ketzelG-22310245/All-Magnetic-Terrain-Quadruped-AMTQ-/ros2_ws/src/quadruped_description/quadruped/assets/support_right_3__3_5__3_5__diameter_hole1.stl

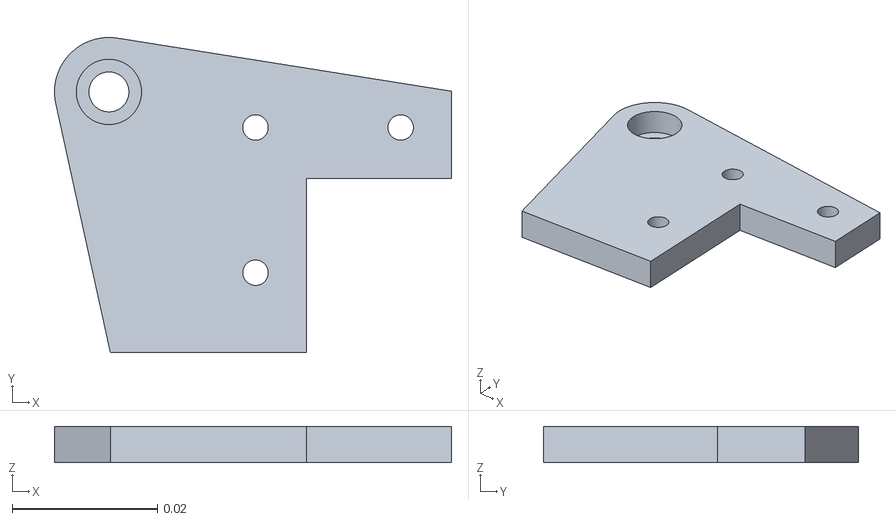
[picture p40: CAD file, 2026-09-14]
ros2_ws/src/quadruped_description/quadruped/assets/support_right_3__3_5__3_5__diameter_hole1.stl
0.0547 x 0.0434 x 0.005
