ketzelG-22310245/All-Magnetic-Terrain-Quadruped-AMTQ-/ros2_ws/src/quadruped_description/quadruped/assets/servo_motor_35kg__body9.stl

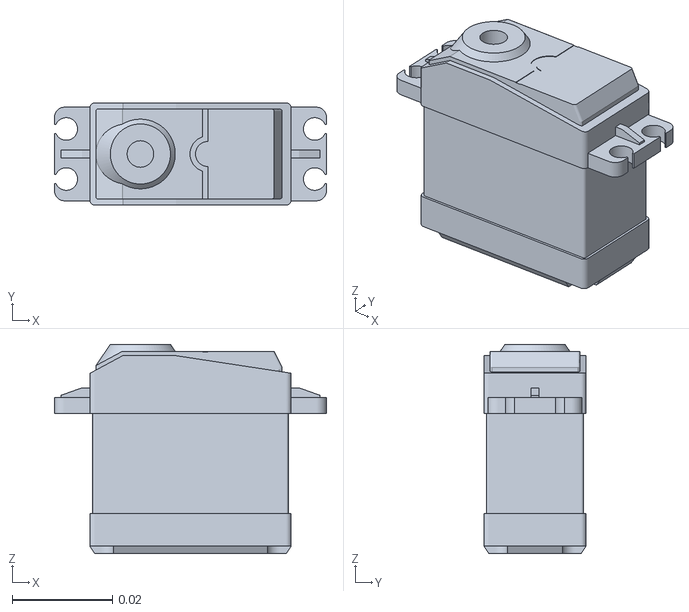
[picture p41: CAD file, 2026-09-14]
ros2_ws/src/quadruped_description/quadruped/assets/servo_motor_35kg__body9.stl
0.0543 x 0.0204 x 0.0418
