ketzelG-22310245/All-Magnetic-Terrain-Quadruped-AMTQ-/ros2_ws/src/quadruped_description/quadruped/assets/case__cut_extrude7.stl

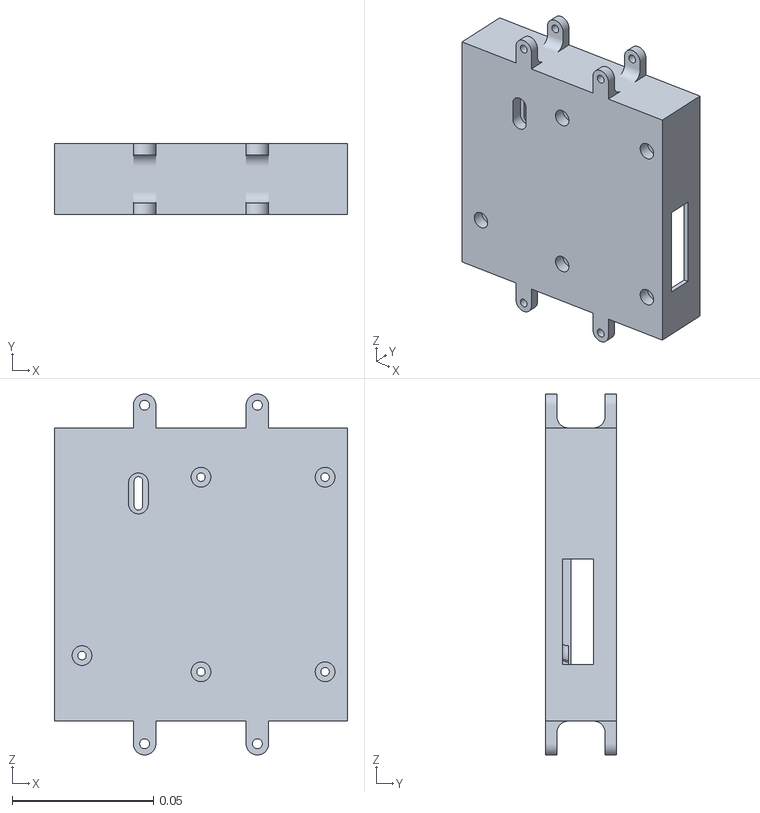
[picture p42: CAD file, 2026-09-14]
ros2_ws/src/quadruped_description/quadruped/assets/case__cut_extrude7.stl
0.104 x 0.025 x 0.128
