ketzelG-22310245/All-Magnetic-Terrain-Quadruped-AMTQ-/ros2_ws/src/quadruped_description/quadruped/assets/pata_con_iman__cut_extrude6.stl

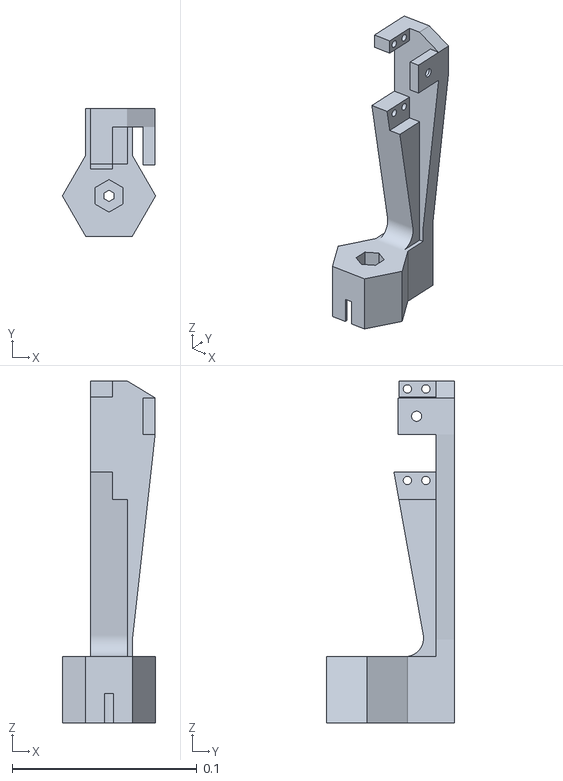
[picture p43: CAD file, 2026-09-14]
ros2_ws/src/quadruped_description/quadruped/assets/pata_con_iman__cut_extrude6.stl
0.0506 x 0.0691 x 0.185
