ketzelG-22310245/All-Magnetic-Terrain-Quadruped-AMTQ-/ros2_ws/src/quadruped_description/quadruped/assets/arm_2_3__cut_extrude4.stl

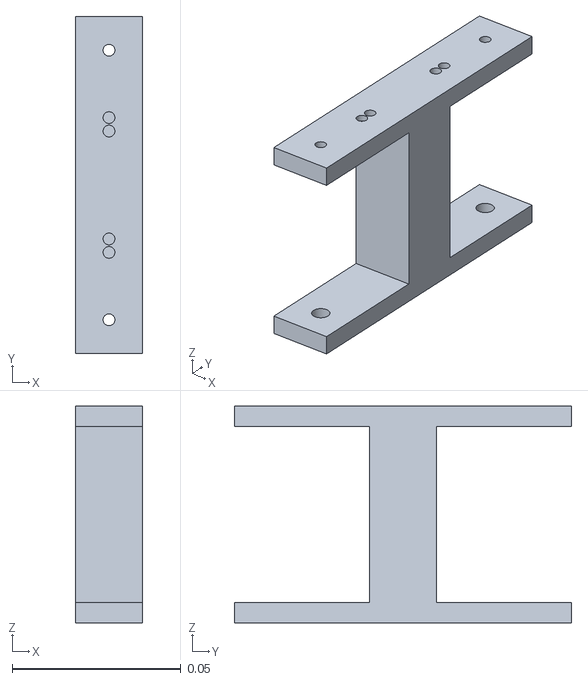
[picture p44: CAD file, 2026-09-14]
ros2_ws/src/quadruped_description/quadruped/assets/arm_2_3__cut_extrude4.stl
0.02 x 0.1 x 0.0643
