ketzelG-22310245/All-Magnetic-Terrain-Quadruped-AMTQ-/ros2_ws/src/quadruped_description/quadruped/assets/aluminium_25t_servo_horn_3__body1.stl

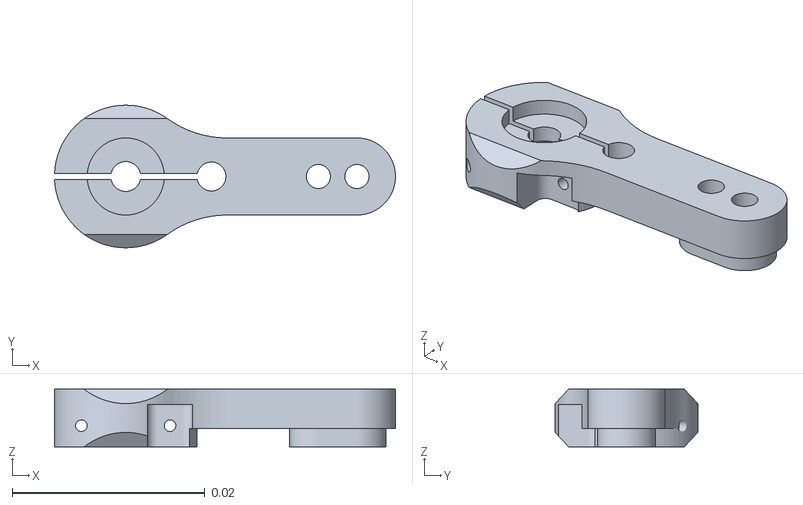
[picture p45: CAD file, 2026-09-14]
ros2_ws/src/quadruped_description/quadruped/assets/aluminium_25t_servo_horn_3__body1.stl
0.0354 x 0.0148 x 0.006
