ketzelG-22310245/All-Magnetic-Terrain-Quadruped-AMTQ-/ros2_ws/src/quadruped_description/quadruped/assets/servo_holder_3__boss_extrude1.stl

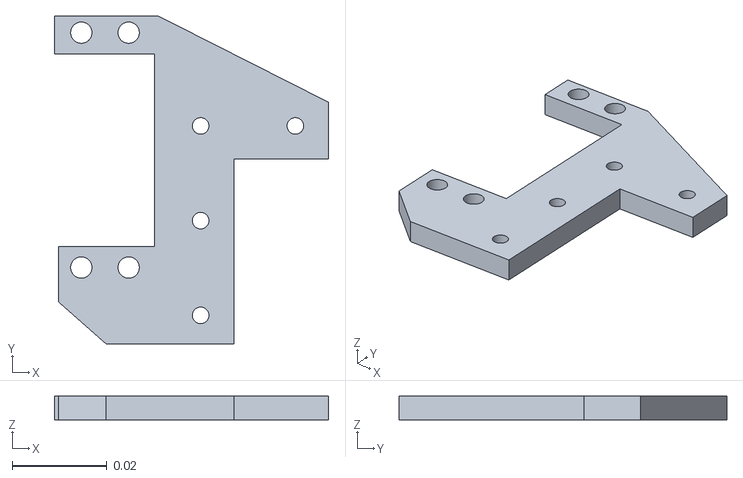
[picture p46: CAD file, 2026-09-14]
ros2_ws/src/quadruped_description/quadruped/assets/servo_holder_3__boss_extrude1.stl
0.0579 x 0.0692 x 0.005
