ketzelG-22310245/All-Magnetic-Terrain-Quadruped-AMTQ-/ros2_ws/src/quadruped_description/quadruped/assets/base_link.stl

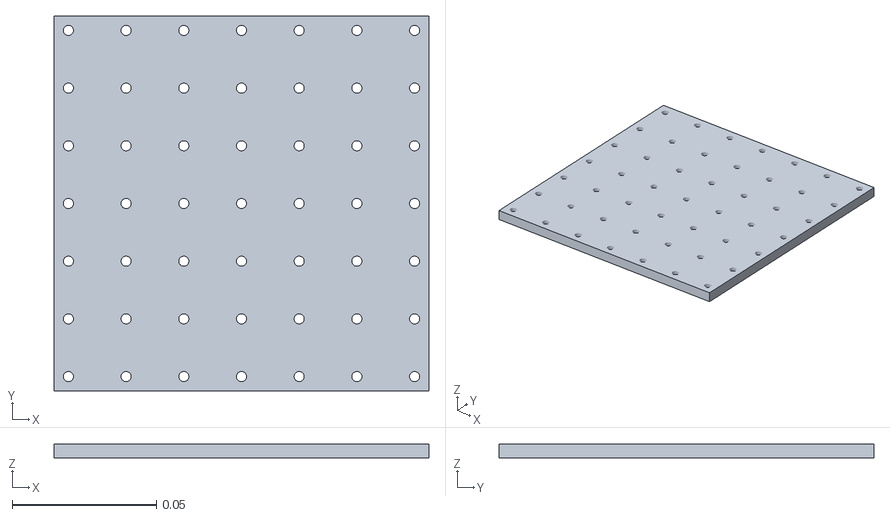
[picture p47: CAD file, 2026-09-14]
ros2_ws/src/quadruped_description/quadruped/assets/base_link.stl
0.13 x 0.13 x 0.005
