ketzelG-22310245/All-Magnetic-Terrain-Quadruped-AMTQ-/ros2_ws/src/quadruped_description/quadruped/assets/arm_1_3__cut_extrude2.stl

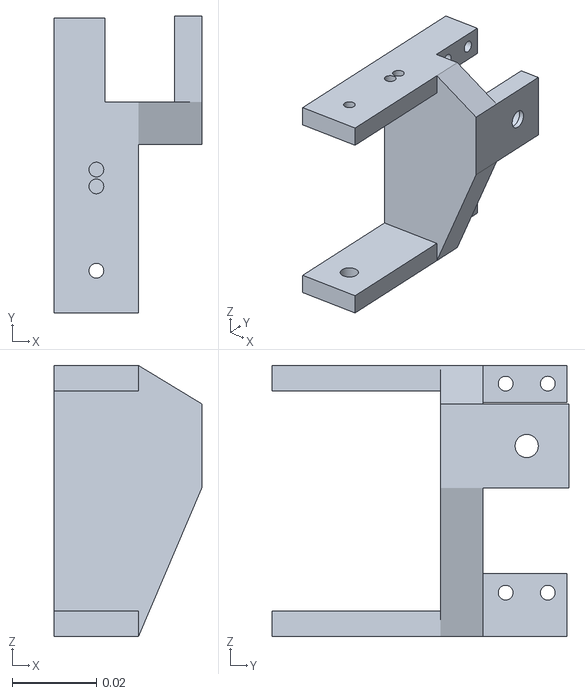
[picture p48: CAD file, 2026-09-14]
ros2_ws/src/quadruped_description/quadruped/assets/arm_1_3__cut_extrude2.stl
0.035 x 0.0704 x 0.0643
