ketzelG-22310245/All-Magnetic-Terrain-Quadruped-AMTQ-/(list of files, cad)

Other CAD files:
ros2_ws/src/quadruped_description/quadruped/assets/support_left_3__3_5__3_5__diameter_hole1.stl
