ketzelG-22310245/All-Magnetic-Terrain-Quadruped-AMTQ-/ros2_ws/femur_step_response.csv

time_s | torque_cmd_Nm | position_rad | velocity_rad_s | effort_measured_Nm
0.0007154941558837891 | 0.0 | -1.0874509452640863e-13 | 0.0 | 0.13982759152765933
0.0017611980438232422 | 0.0 | -1.0874510840419644e-13 | -1.3877787807814457e-17 | 0.1398275915276541
0.0023915767669677734 | 0.0 | -1.0874509452640863e-13 | 0.0 | 0.1398275915276491
0.0029904842376708984 | 0.0 | -1.0874513615977206e-13 | 1.3877787807814457e-17 | 0.13982759152764399
0.0033845901489257812 | 0.0 | -1.0874515003755987e-13 | -2.7755575615628914e-17 | 0.13982759152763888
0.003760814666748047 | 0.0 | -1.0874508064862083e-13 | -1.3877787807814457e-17 | 0.13982759152763366
0.004301548004150391 | 0.0 | -1.0874508064862083e-13 | 1.3877787807814457e-17 | 0.13982759152762872
0.0048558712005615234 | 0.0 | -1.0874509452640864e-13 | -1.3877787807814457e-17 | 0.1398275915276235
0.0053806304931640625 | 0.0 | -1.0874513615977206e-13 | -1.3877787807814457e-17 | 0.13982759152761842
0.0060710906982421875 | 0.0 | -1.0874515003755987e-13 | -1.3877787807814457e-17 | 0.13982759152761334
0.012759685516357422 | 0.0 | -1.0874510840419644e-13 | 1.3877787807814457e-17 | 0.13982759152760824
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
