ketzelG-22310245/All-Magnetic-Terrain-Quadruped-AMTQ-/docs/Planos AMTQ Nuevo Logo.pdf

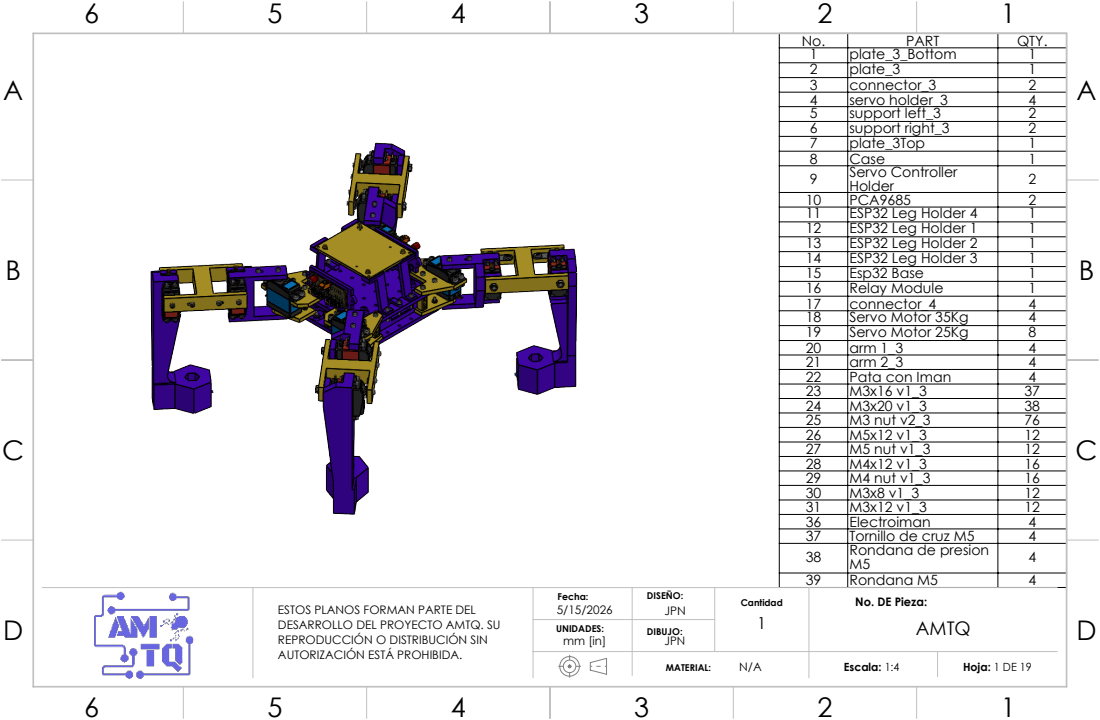
[picture p49: page 1]
PART; QTY. 1; plate_3_Bottom; plate_3; connector_3; servo holder_3; support left_3; support right_3; plate_3Top; Case; Servo Controller; Rondana M5; Cantidad; No. DE Pieza:; MATERIAL:; Escala: 1:4; Hoja: 1 DE 19; 1 DIBUJO:

Holder | 2
10 | PCA9685 | 2
11 | ESP32 Leg Holder 4 | 1
12 | ESP32 Leg Holder 1 | 1
13 | ESP32 Leg Holder 2 | 1
14 | ESP32 Leg Holder 3 | 1
15 | Esp32 Base | 1
16 | Relay Module | 1
17 | connector_4 | 4
18 | Servo Motor 35Kg | 4
19 | Servo Motor 25Kg | 8
20 | arm 1_3 | 4
21 | arm 2_3 | 4
22 | Pata con Iman | 4
23 | M3x16 v1_3 | 37
24 | M3x20 v1_3 | 38
25 | M3 nut v2_3 | 76
26 | M5x12 v1_3 | 12
27 | M5 nut v1_3 | 12
28 | M4x12 v1_3 | 16
29 | M4 nut v1_3 | 16
30 | M3x8 v1_3 | 12
31 | M3x12 v1_3 | 12
36 | Electroiman | 4
37 | Tornillo de cruz M5 | 4
38 | Rondana de presion M5 | 4

ESTOS PLANOS FORMAN PARTE DEL
DESARROLLO DEL PROYECTO AMTQ. SU
REPRODUCCIÓN O DISTRIBUCIÓN SIN
AUTORIZACIÓN ESTÁ PROHIBIDA.

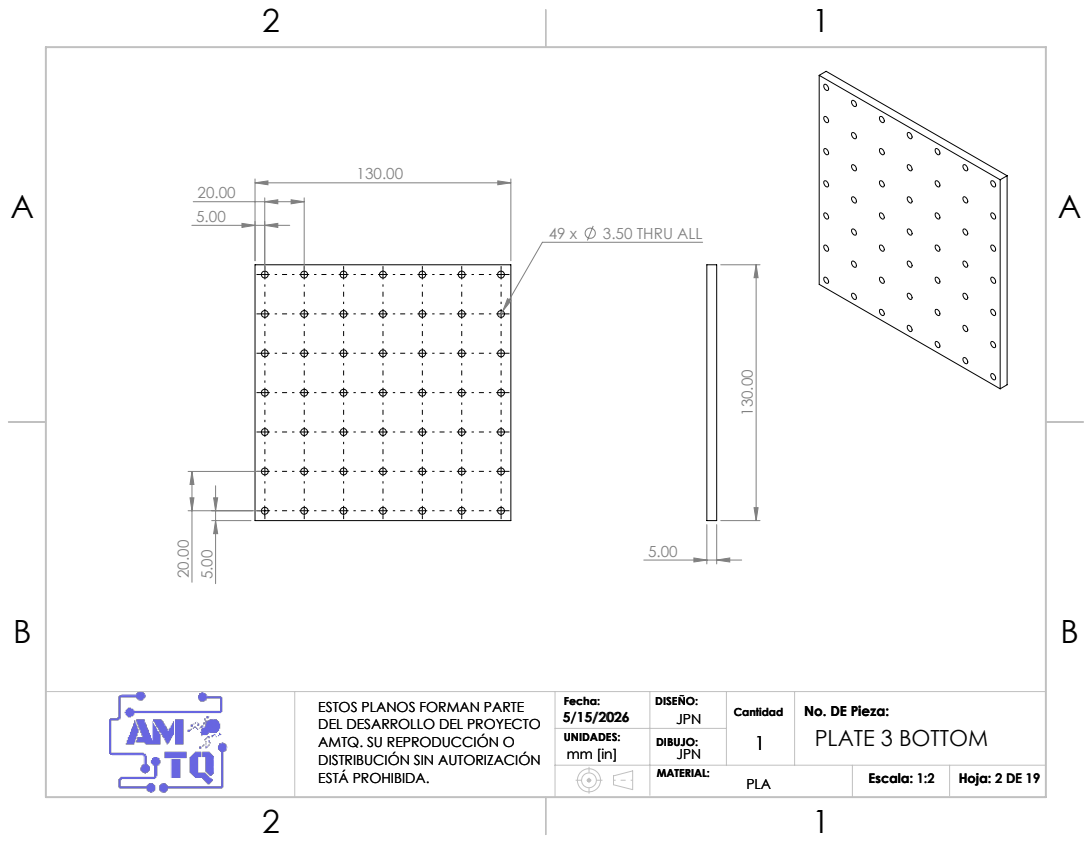
[picture p50: page 2]
3.50 THRU ALL; Cantidad; No. DE Pieza:; MATERIAL:; Escala: 1:2; Hoja: 2 DE 19; PLATE 3 BOTTOM

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

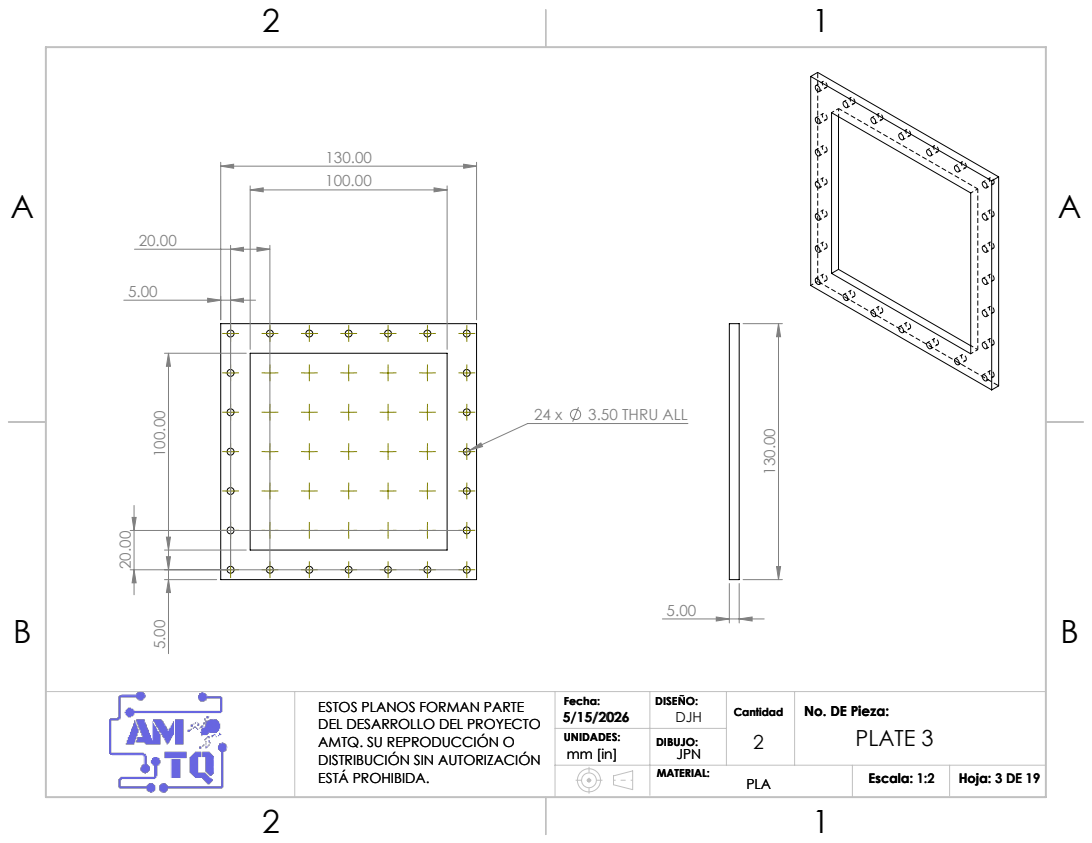
[picture p51: page 3]
3.50 THRU ALL; Cantidad; No. DE Pieza:; MATERIAL:; Escala: 1:2; Hoja: 3 DE 19; PLATE 3

ESTOS PLANOS FORMAN PARTE
DEL DESARROLLO DEL PROYECTO

AMTQ. SU REPRODUCCIÓN O
DISTRIBUCIÓN SIN AUTORIZACIÓN
ESTÁ PROHIBIDA.

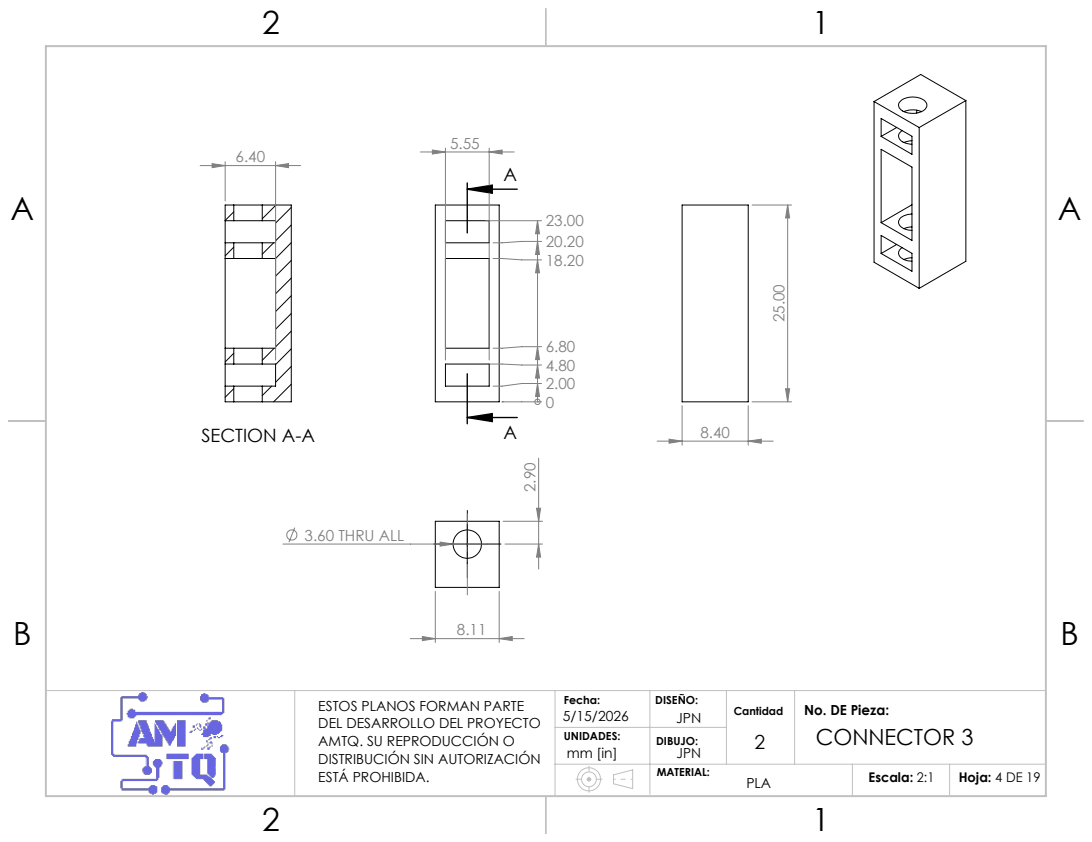
[picture p52: page 4]
3.60 THRU ALL; SECTION A-A; Cantidad; No. DE Pieza:; MATERIAL:; Escala: 2:1; Hoja: 4 DE 19; CONNECTOR 3

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

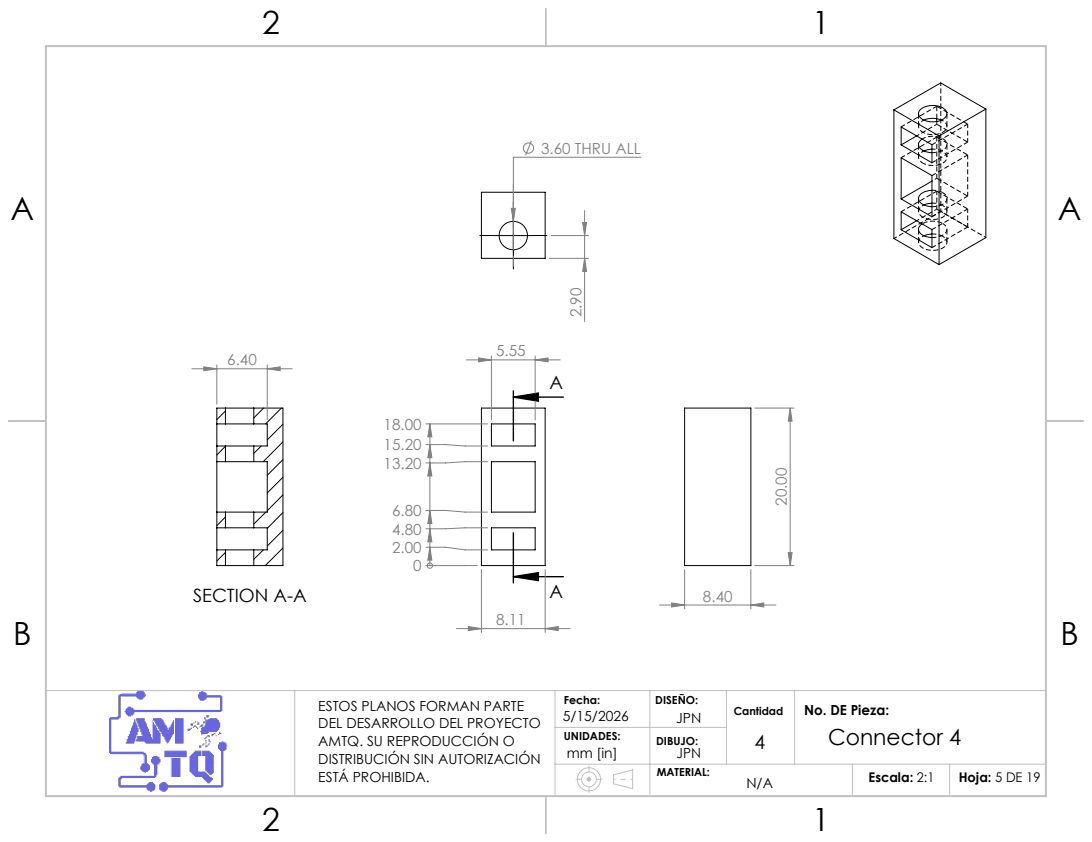
[picture p53: page 5]
3.60 THRU ALL; SECTION A-A; Cantidad; No. DE Pieza:; MATERIAL:; Escala: 2:1; Hoja: 5 DE 19; Connector 4

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

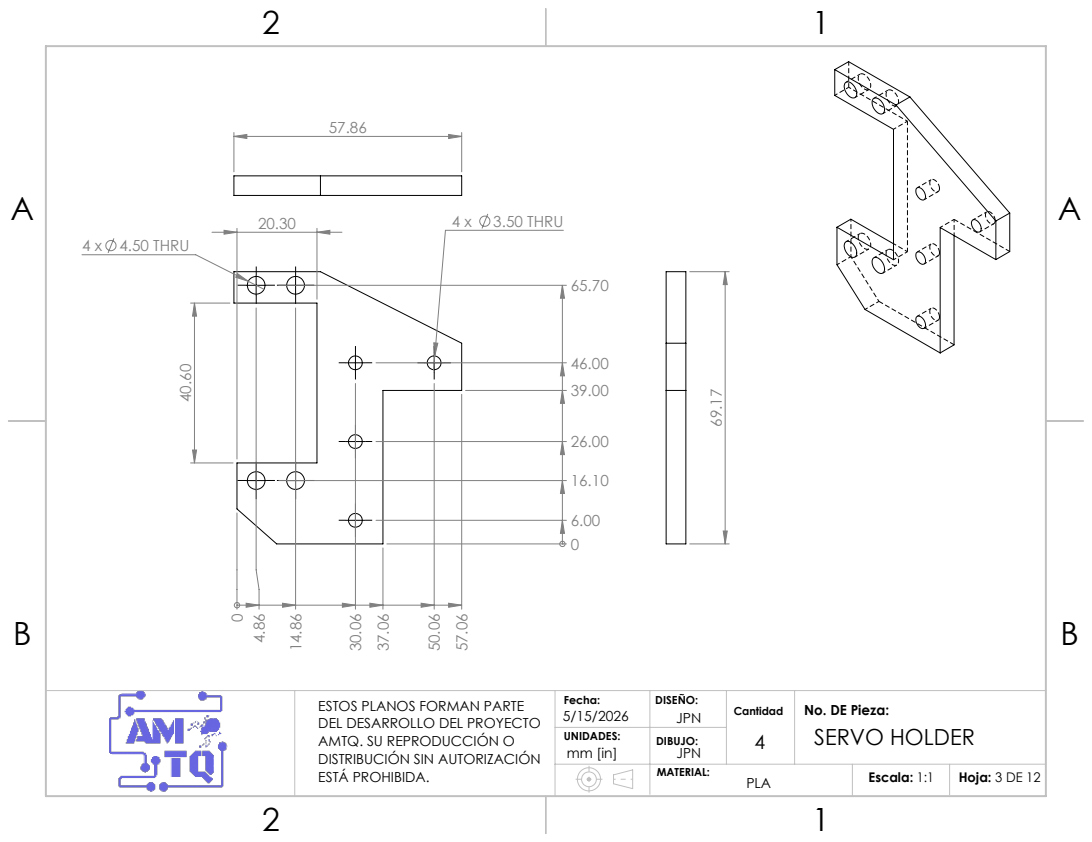
[picture p54: page 6]
4 x 3.50 THRU; 4 x 4.50 THRU; Cantidad; No. DE Pieza:; MATERIAL:; Escala: 1:1; Hoja: 3 DE 12; SERVO HOLDER

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

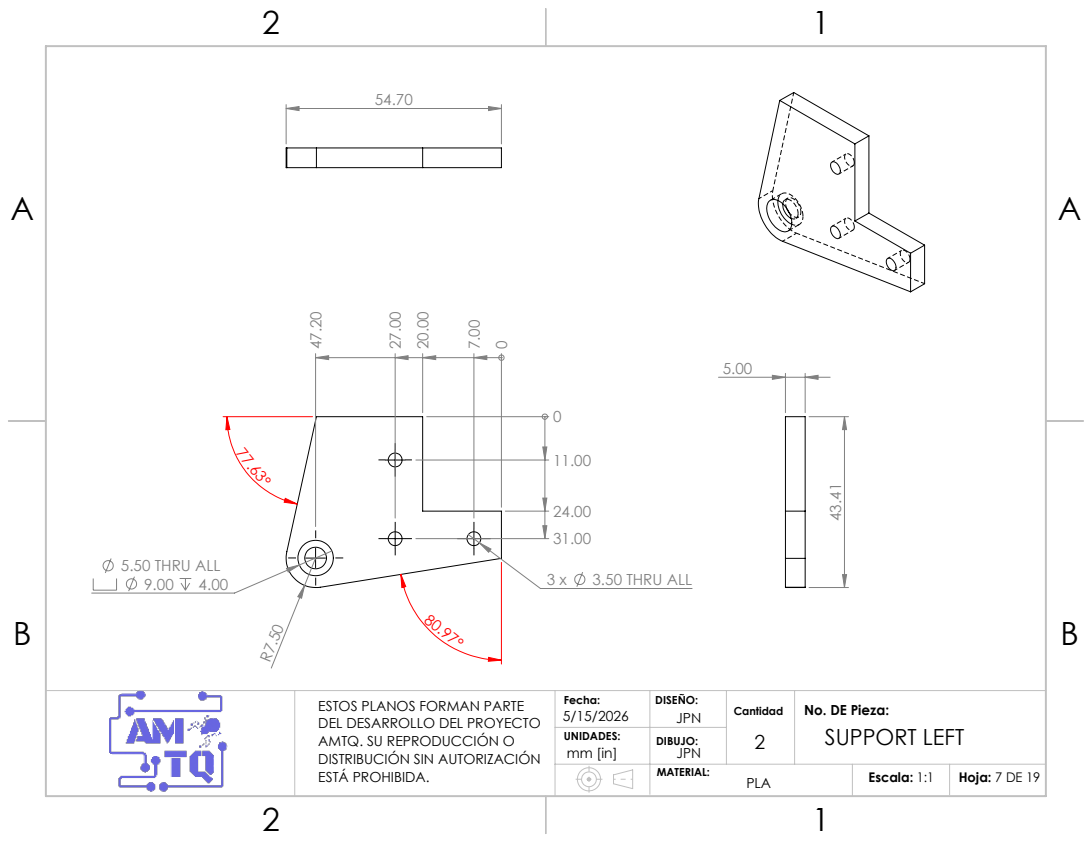
[picture p55: page 7]
5.50 THRU ALL; 3.50 THRU ALL; Cantidad; No. DE Pieza:; MATERIAL:; Escala: 1:1; Hoja: 7 DE 19; SUPPORT LEFT

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

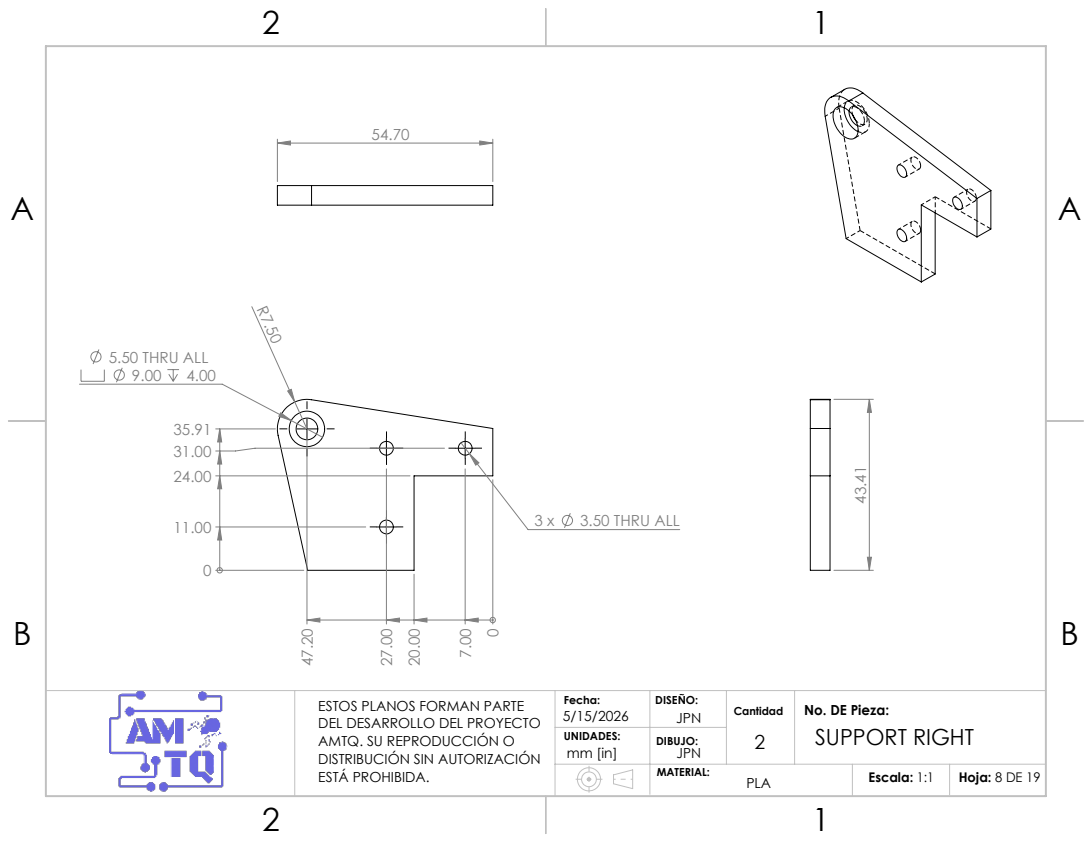
[picture p56: page 8]
5.50 THRU ALL 9.00 4.00; 3.50 THRU ALL; Cantidad; No. DE Pieza:; MATERIAL:; Escala: 1:1; Hoja: 8 DE 19; SUPPORT RIGHT

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

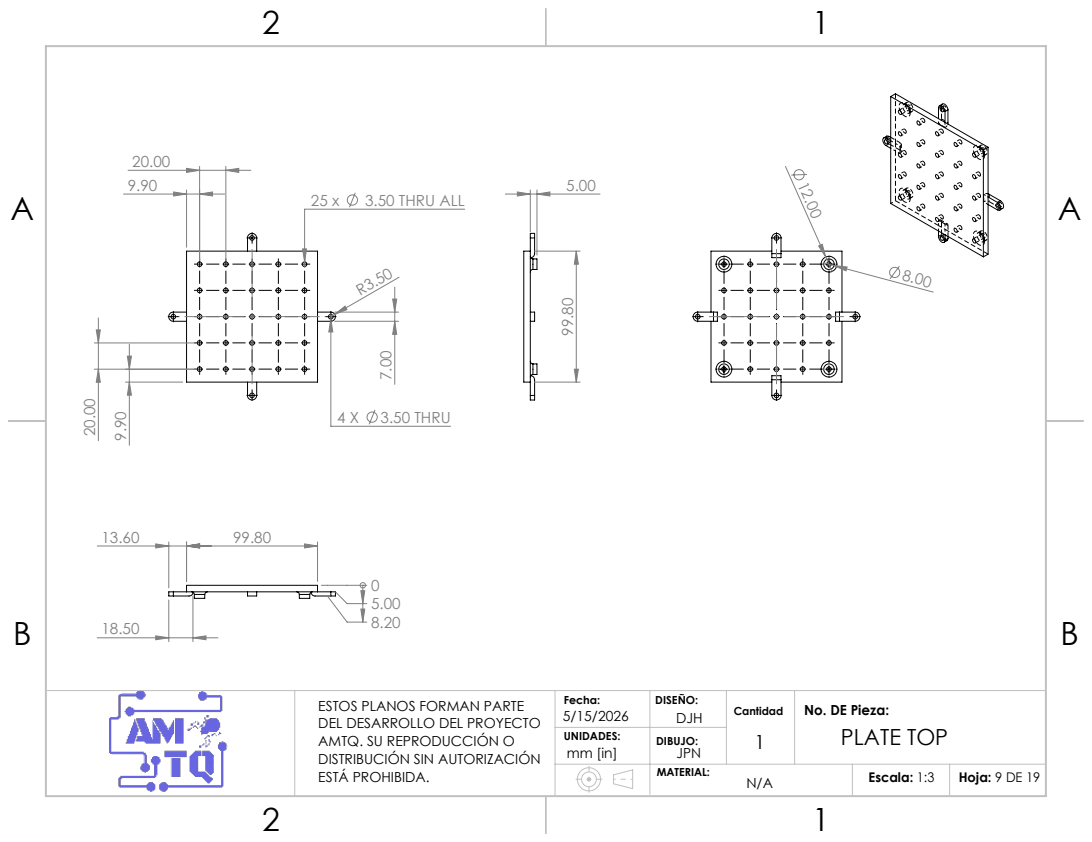
[picture p57: page 9]
3.50 THRU ALL; 4 X 3.50 THRU; Cantidad; No. DE Pieza:; MATERIAL:; Escala: 1:3; Hoja: 9 DE 19; PLATE TOP

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

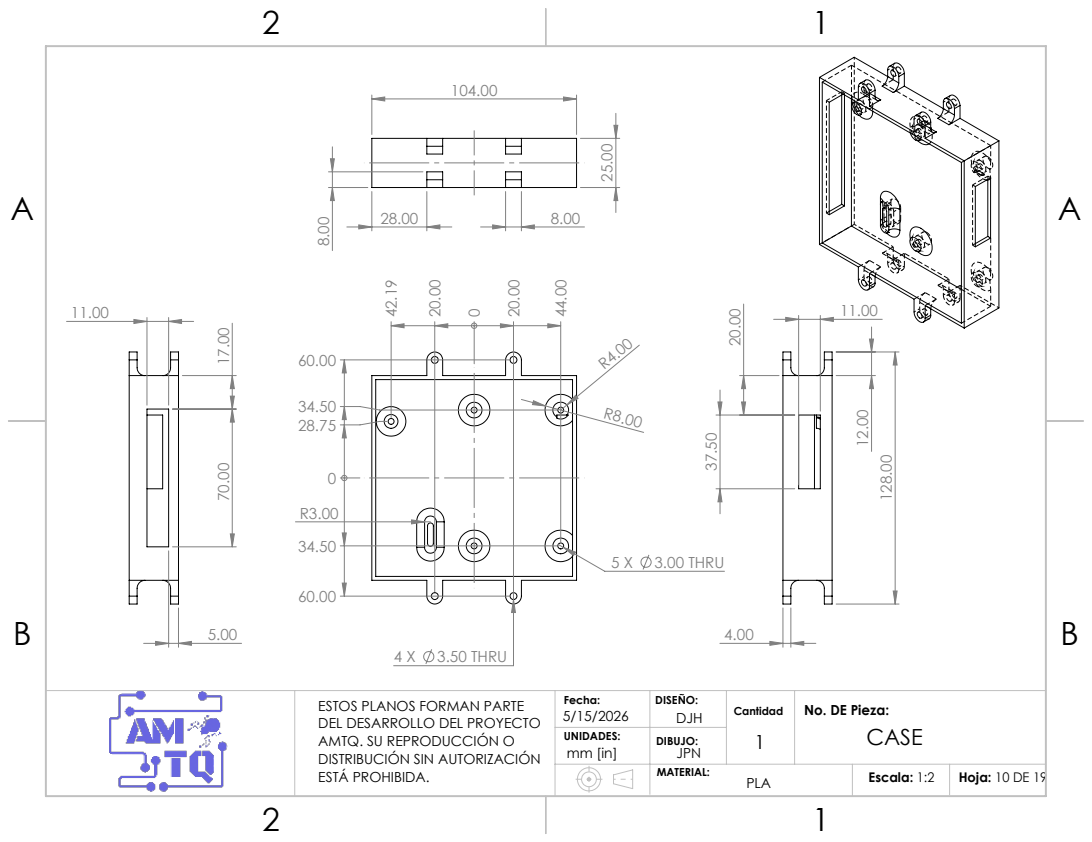
[picture p58: page 10]
5 X 3.00 THRU; 4 X 3.50 THRU; Cantidad; No. DE Pieza:; MATERIAL:; Escala: 1:2; Hoja: 10 DE 19

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

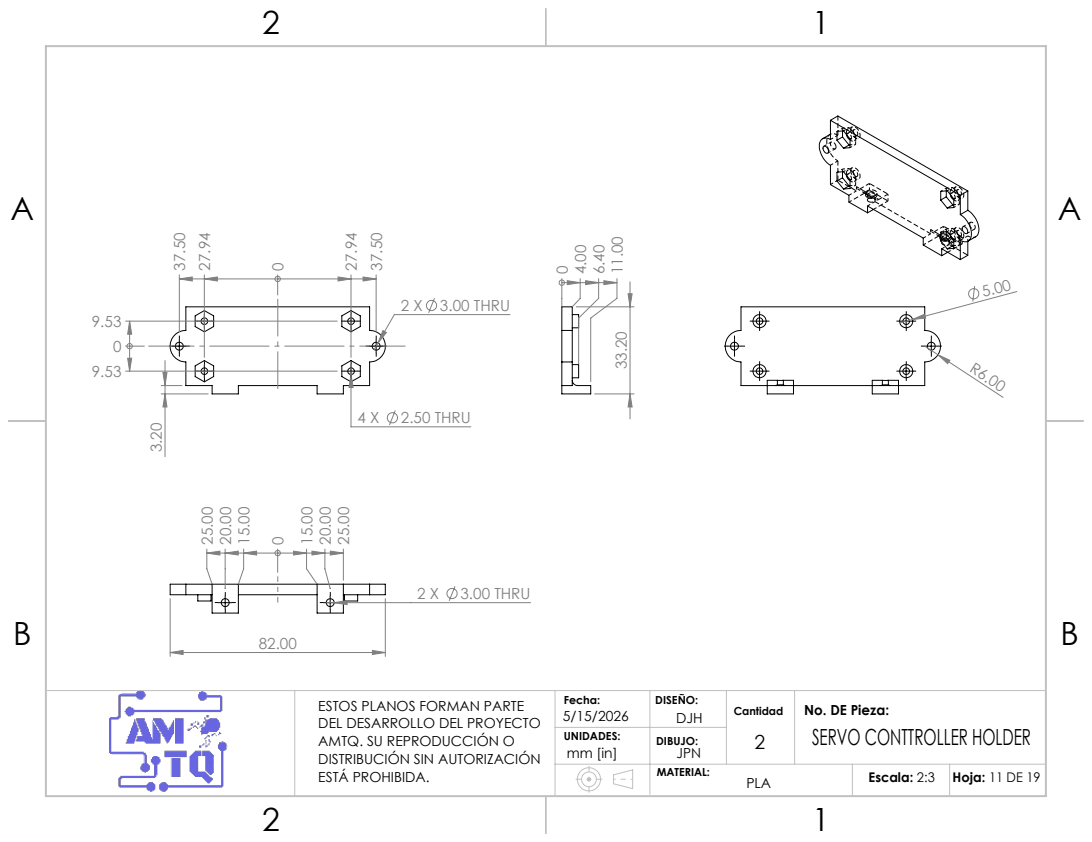
[picture p59: page 11]
2 X 3.00 THRU; 4 X 2.50 THRU; Cantidad; No. DE Pieza:; MATERIAL:; Escala: 2:3 Hoja: 11 DE 19

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

SERVO CONTTROLLER HOLDER

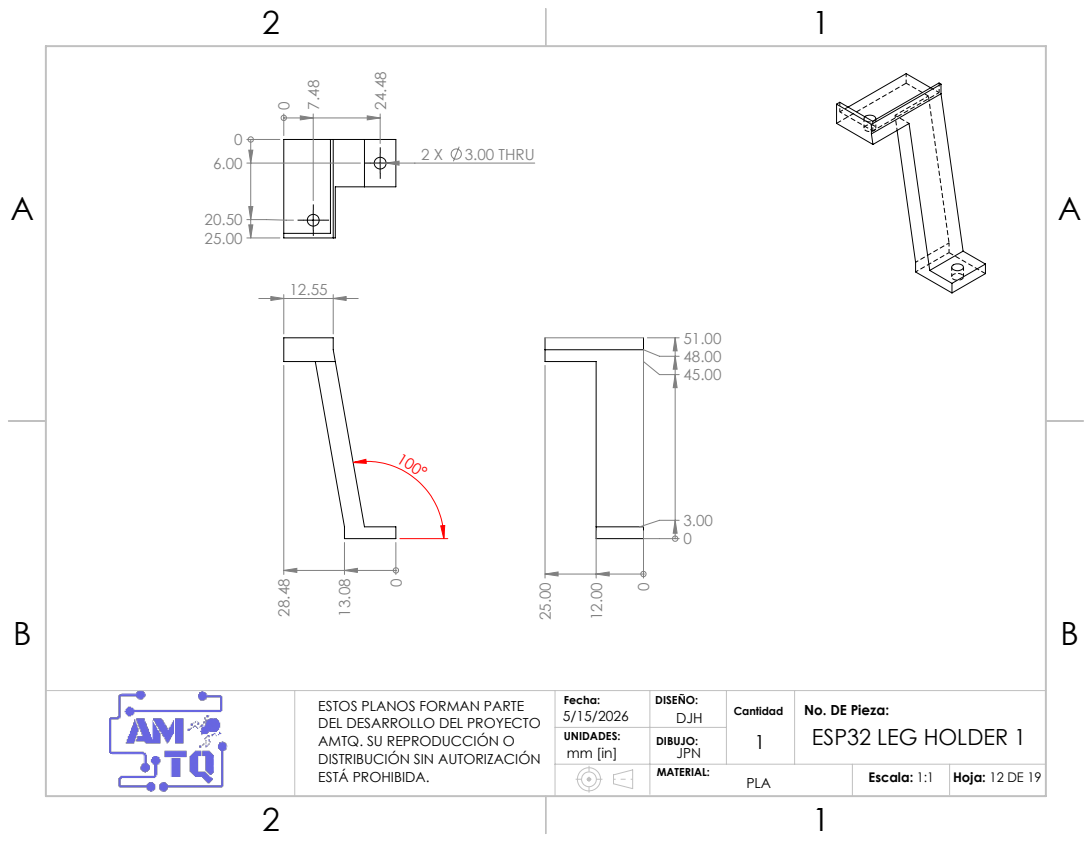
[picture p60: page 12]
2 X 3.00 THRU; Cantidad; No. DE Pieza:; MATERIAL:; Escala: 1:1 Hoja: 12 DE 19; ESP32 LEG HOLDER 1

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

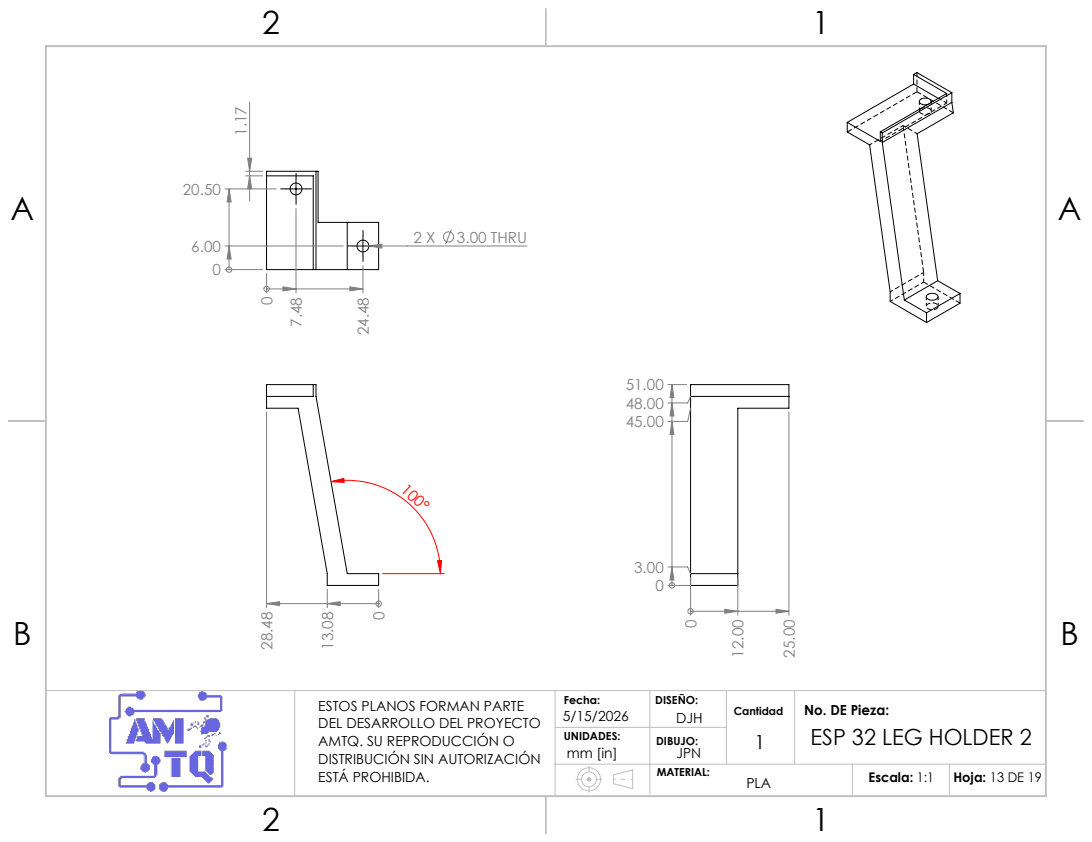
[picture p61: page 13]
2 X 3.00 THRU; Cantidad; No. DE Pieza:; MATERIAL:; Escala: 1:1 Hoja: 13 DE 19

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

ESP 32 LEG HOLDER 2

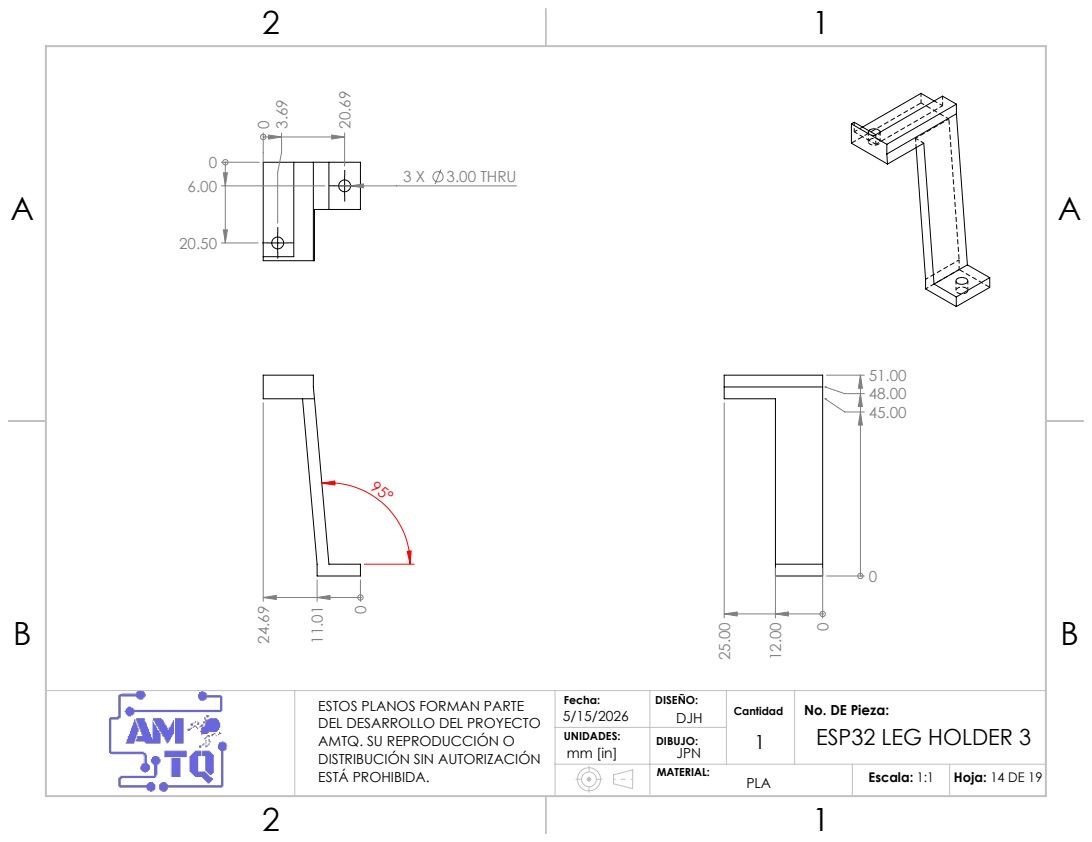
[picture p62: page 14]
3 X 3.00 THRU; Cantidad; No. DE Pieza:; MATERIAL:; Escala: 1:1 Hoja: 14 DE 19; ESP32 LEG HOLDER 3

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

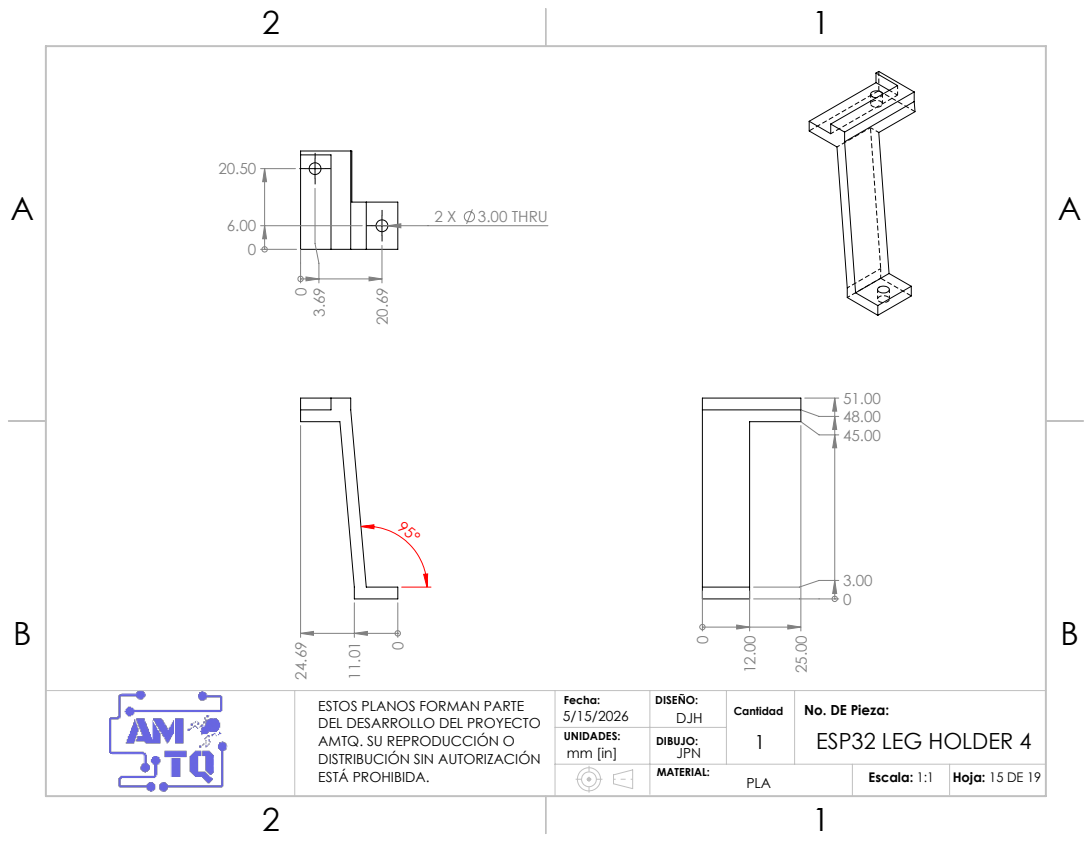
[picture p63: page 15]
2 X 3.00 THRU; Cantidad; No. DE Pieza:; MATERIAL:; Escala: 1:1 Hoja: 15 DE 19; ESP32 LEG HOLDER 4

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

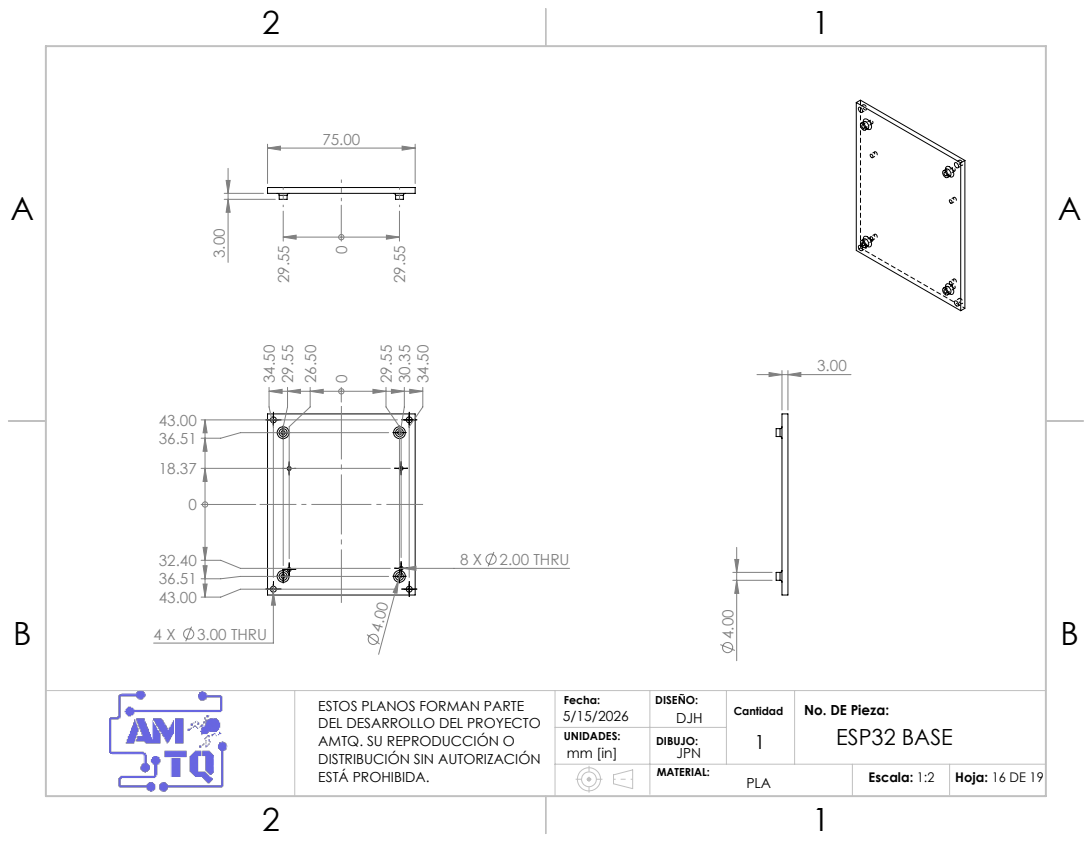
[picture p64: page 16]
4 X 3.00 THRU; 8 X 2.00 THRU; Cantidad; No. DE Pieza:; MATERIAL:; Escala: 1:2 Hoja: 16 DE 19; ESP32 BASE

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

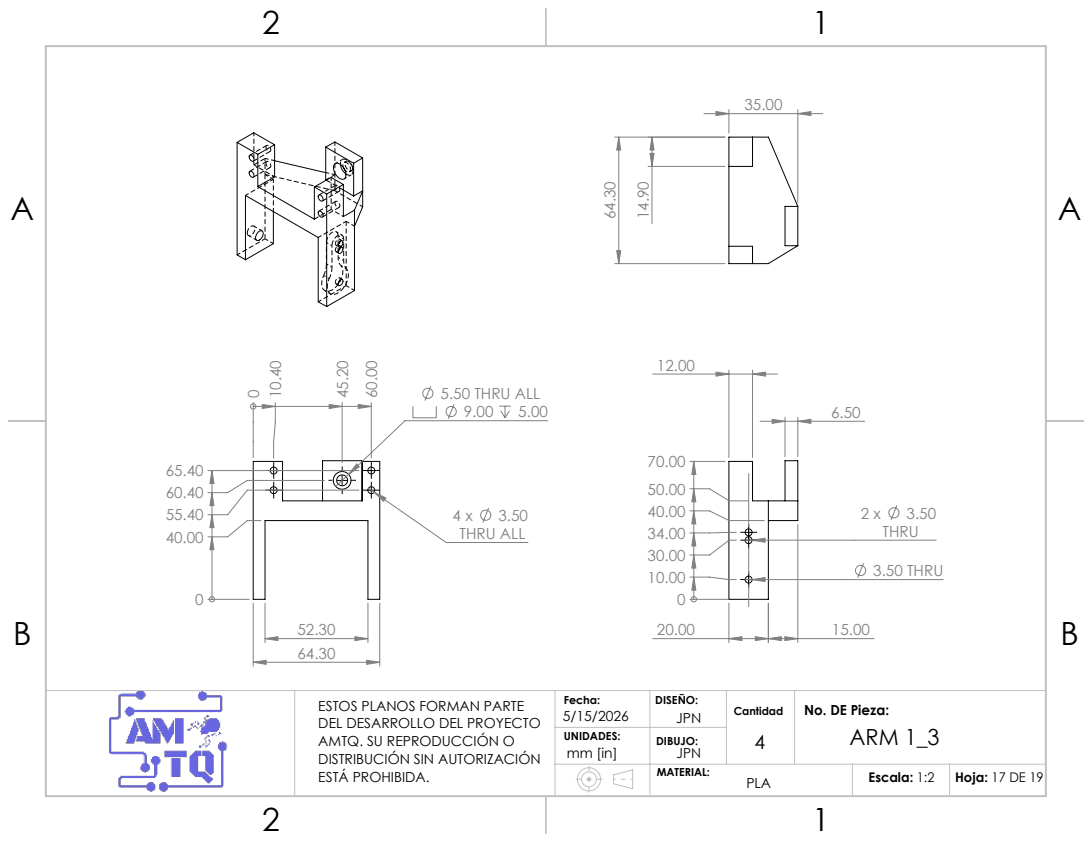
[picture p65: page 17]
3.50 THRU; THRU ALL; 5.50 THRU ALL 9.00 5.00; Cantidad; No. DE Pieza:; MATERIAL:; Escala: 1:2 Hoja: 17 DE 19; ARM 1_3

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

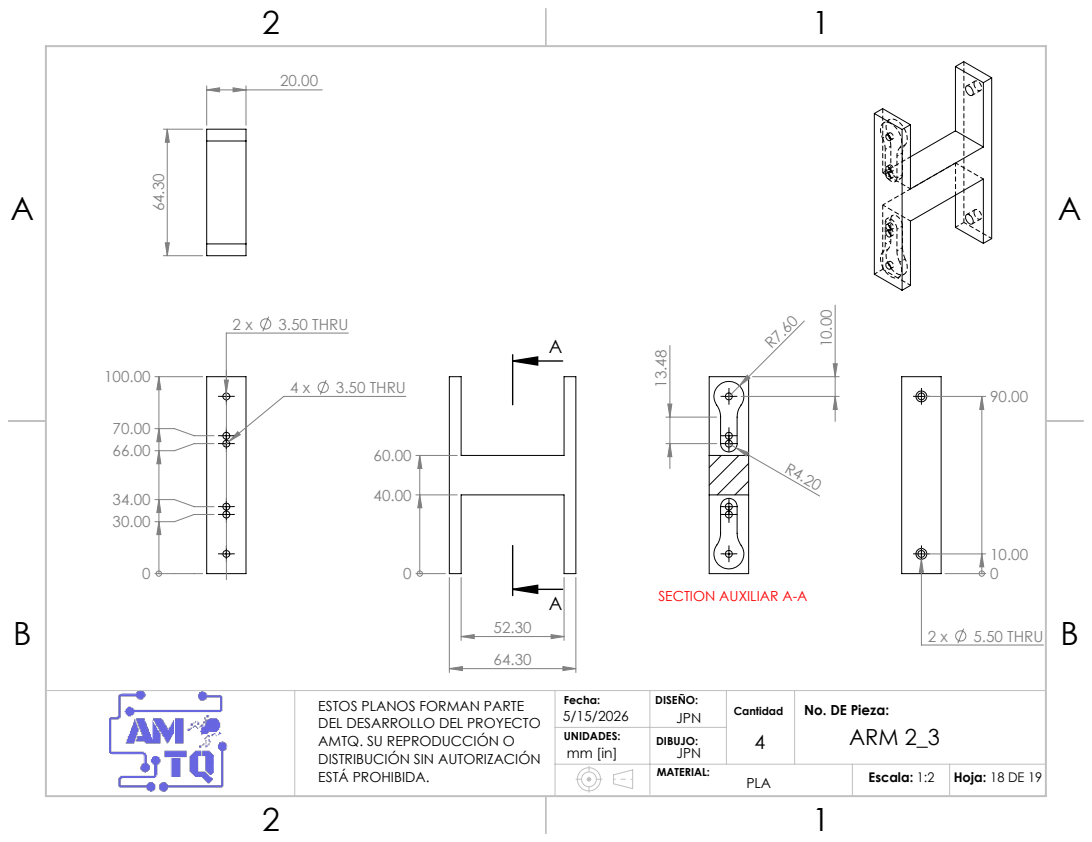
[picture p66: page 18]
3.50 THRU; SECTION AUXILIAR A-A; 5.50 THRU; Cantidad; No. DE Pieza:; MATERIAL:; Escala: 1:2 Hoja: 18 DE 19; ARM 2_3

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

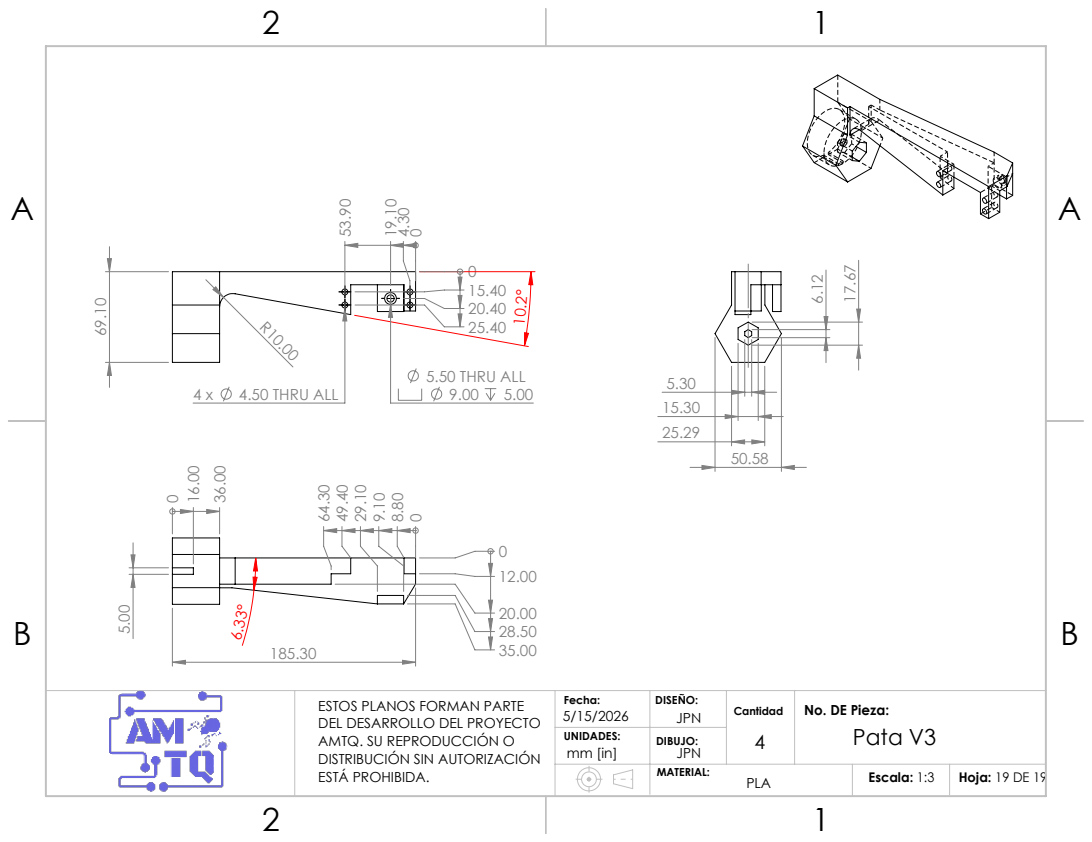
[picture p67: page 19]
4.50 THRU ALL; 5.50 THRU ALL; Cantidad; No. DE Pieza:; MATERIAL:; Escala: 1:3; Hoja: 19 DE 19; Pata V3

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
