ketzelG-22310245/All-Magnetic-Terrain-Quadruped-AMTQ-/(commit log)

2026-09-14 Actualizacion de codigo fuente y workspace
2026-10-20 kinematics DAR
2026-10-24 PID 1.0
2026-10-25 PID 2.0
2026-10-25 PID AND GAIT
2026-10-26 PID CORRECT
