ketzelG-22310245/All-Magnetic-Terrain-Quadruped-AMTQ-/(notices)

Notices in the files:
README.md:
License: MIT
